HyveSynth/HyveSynth/README.md

# Hyve Synth

## By Skot Wiedmann
**Hyve Touch Synth is a fun, expressive musical instrument you can make, hack and play. Build or play a beautiful analog synth that responds to touch and movement!**

### Documentation

In this repository you will find the schematic and playing surface layouts, as well as some useful guides for tuning and DIY building and hacking.

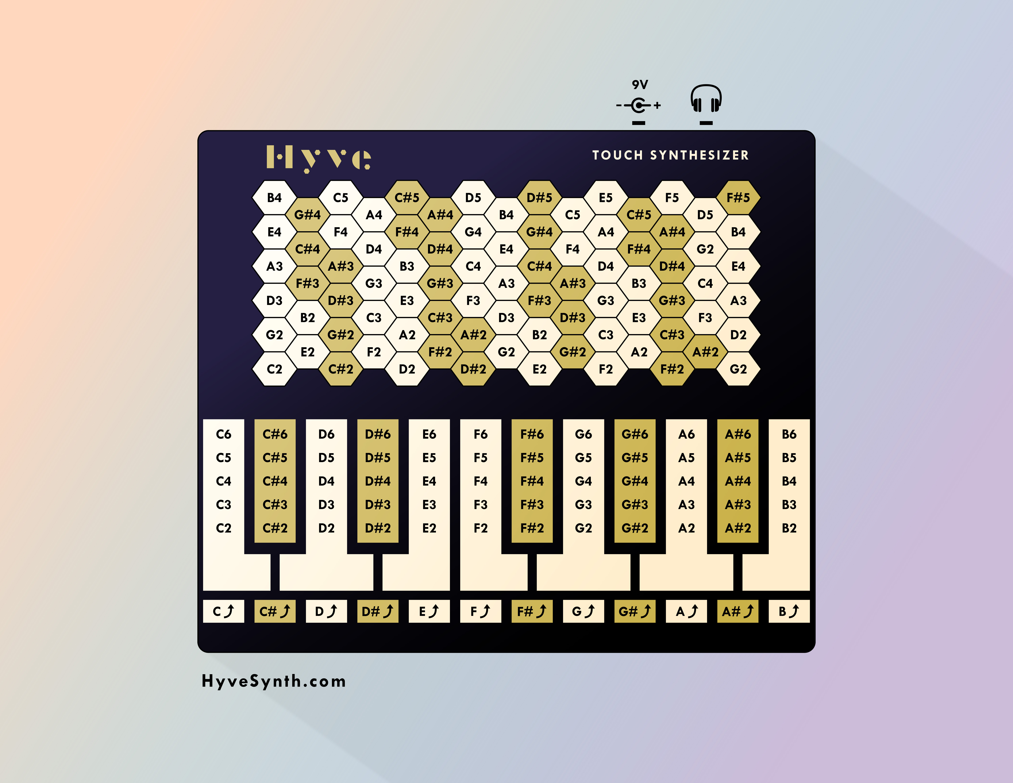
[picture p1: HyveDiagram.jpg]
HyveDiagram
