HyveSynth/HyveSynth/CuttingTemplate1.png

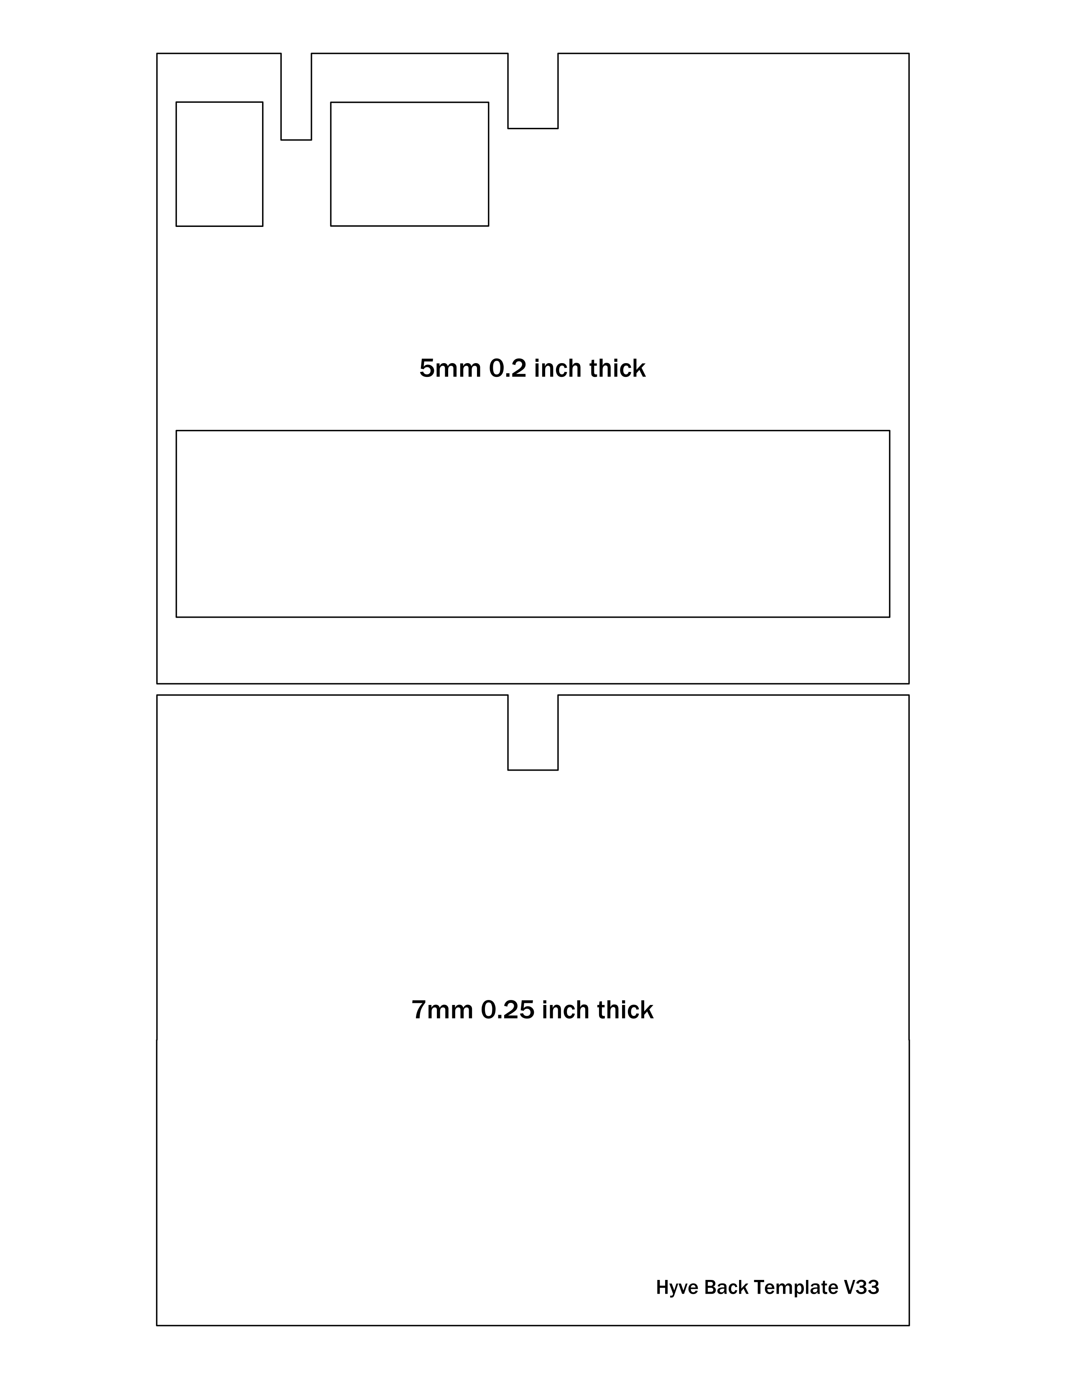
CuttingTemplate1.png
