HyveSynth/HyveSynth/Hyve43Schematic.png

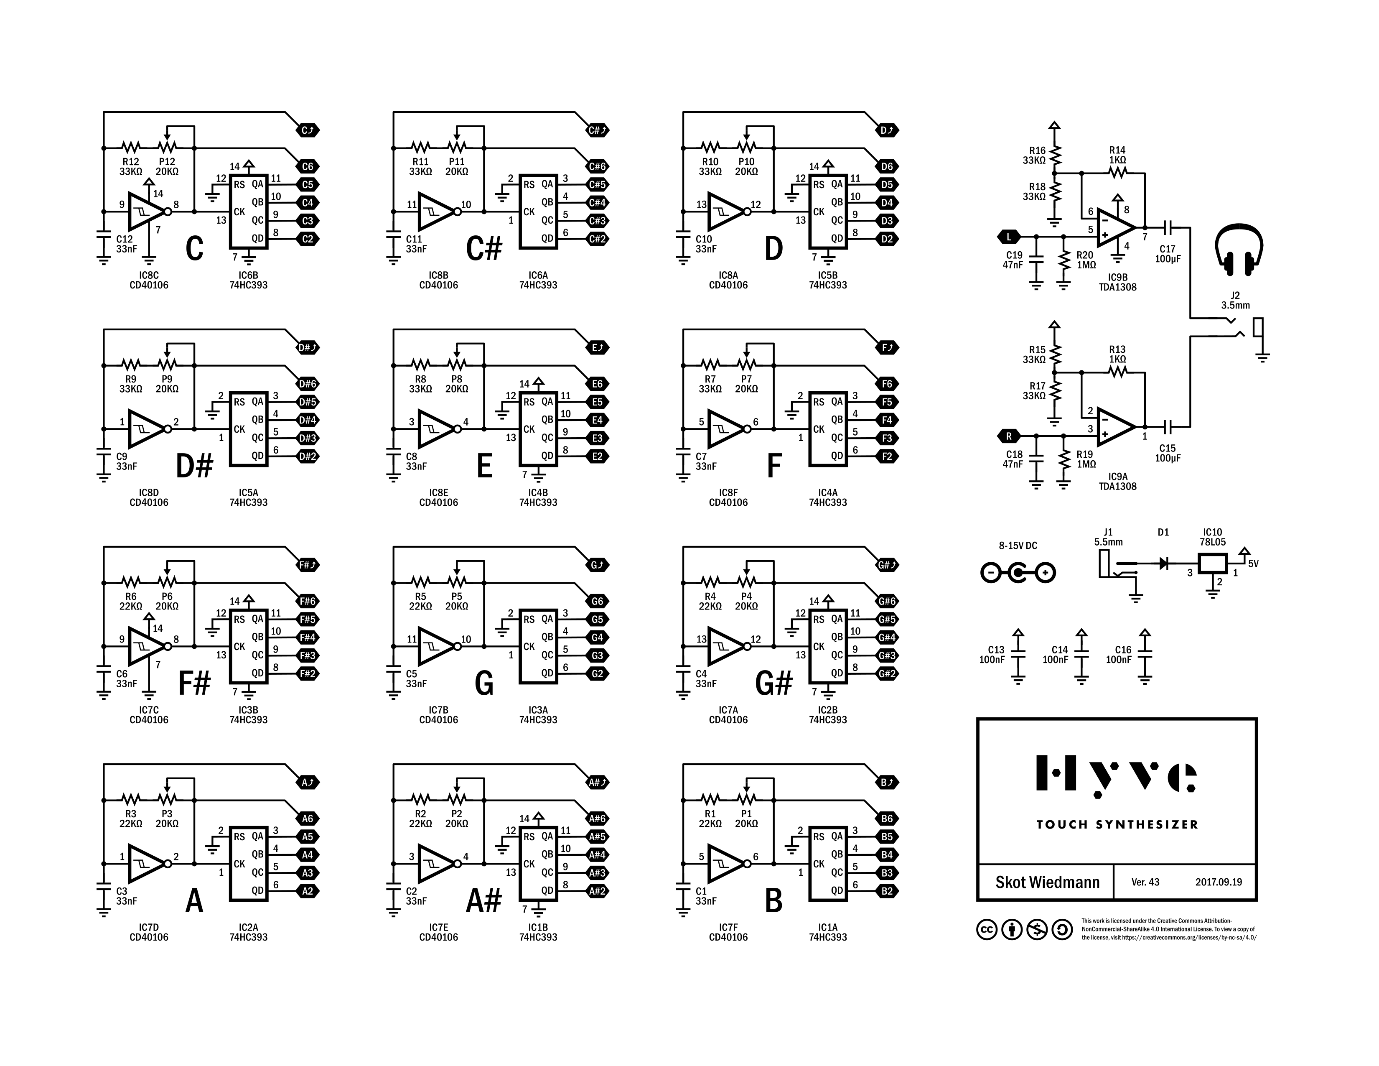
Hyve43Schematic.png
