HyveSynth/HyveSynth/HyveSurfaceLayout.png

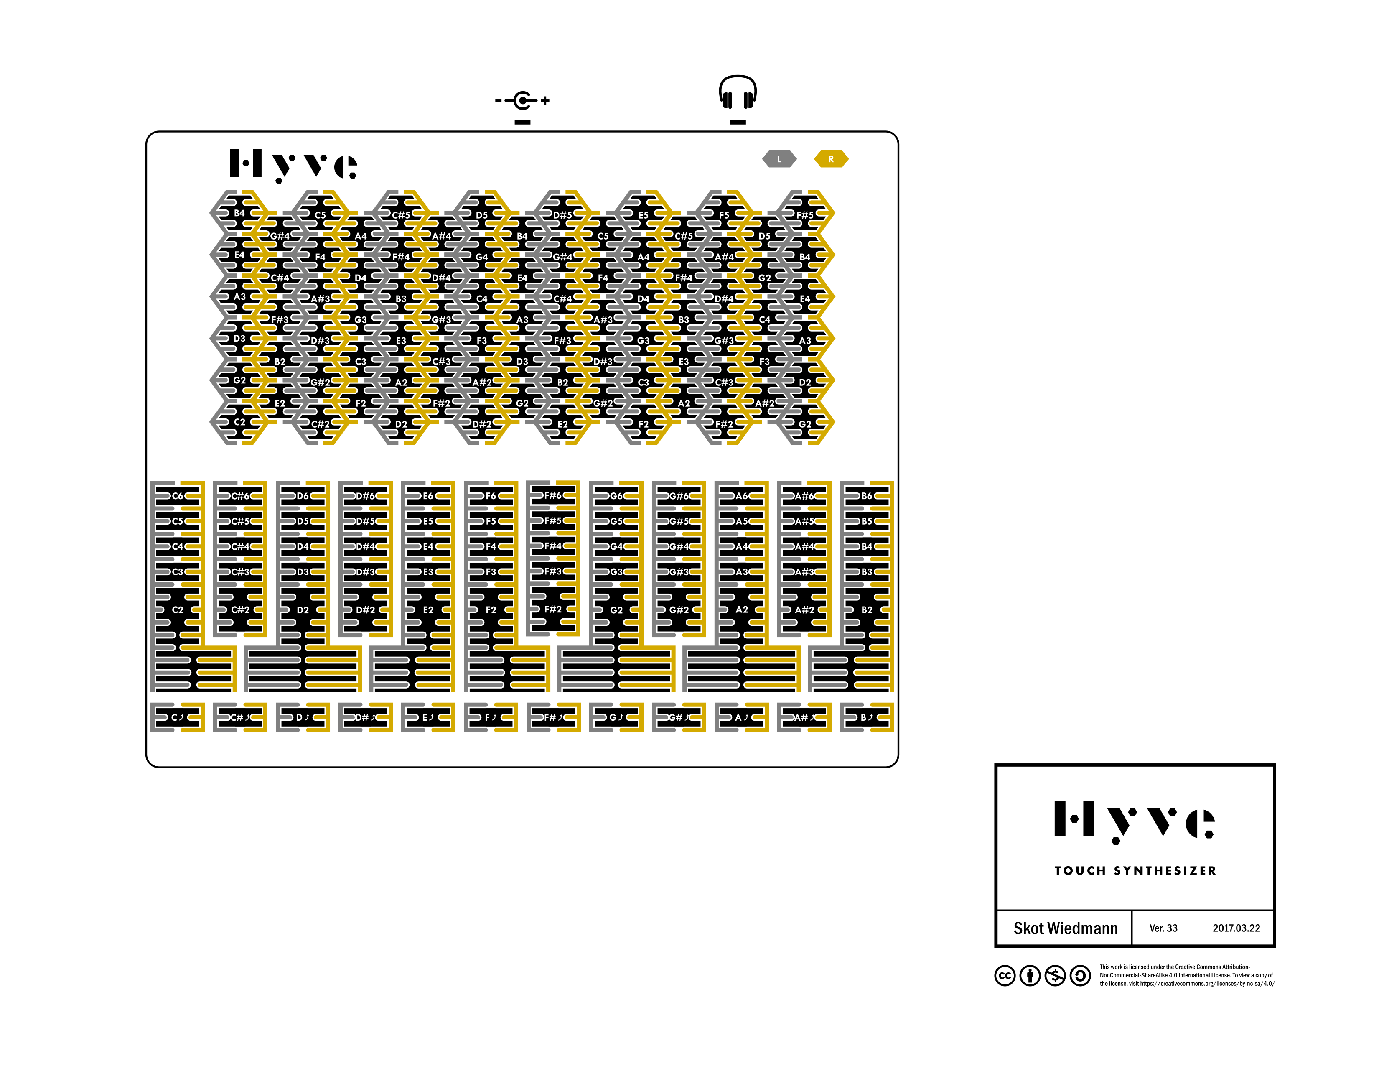
HyveSurfaceLayout.png
