HyveSynth/HyveSynth/Hyve BOM V45.xlsx

Hyve BOM V45 | updated 2019.27.11
Direct Link: | https://www.mouser.com/ProjectManager/ProjectDetail.aspx?AccessID=55c2f2d16f
Digi-Key Part Number | Manufacturer | Manufacturer Part Number | Designator | Quantity | Description | Notes
296-14851-1-ND | TEXAS INSTRUMENTS | SN74HC393DR | IC1 IC2 IC3 IC4 IC5 IC6 | 6 | IC DUAL 4BIT BINRY COUNTR 14SOIC
296-14081-1-ND | TEXAS INSTRUMENTS | CD40106BM96 | IC7 IC8 | 2 | IC INVERTER GATE HEX 14SOIC | Do not substitute
568-11063-1-ND | NXP USA INC | TDA1308T/N2,115 | IC9 | 1 | IC AMP AUDIO 3W STER AB 8SOIC | Substitute: TPA112 or LM4808; SOIC only
296-13531-1-ND | TEXAS INSTRUMENTS | UA78L05CPK | IC10 | 1 | IC REG LDO 5V 0.1A SOT89-3
399-1249-1-ND | KEMET | C1206C104K5RAC7867 | C13 C14 C16 | 3 | CAP CER 0.1UF 50V X7R 1206 | Substitute with any 0.1UF 1206 >6V
36-4003-ND | KEYSTONE ELECTRONICS | 4003 | TUNING TOOL | 1 | CONN TERM LUG RING TH | Optional
TC33X-2-203ECT-ND | BOURNS INC | TC33X-2-203E | P1 P2 P3 P4 P5 P6 P7 P8 P9 P10 P11 P12 | 12 | TRIMMER 20K OHM 0.1W SMD
311-1.0KERCT-ND | YAGEO | RC1206JR-071KL | R13 R14 | 2 | RES SMD 1K OHM 5% 1/4W 1206
311-22KERCT-ND | YAGEO | RC1206JR-0722KL | R1 R2 R3 R4 R5 R6 | 6 | RES SMD 22K OHM 5% 1/4W 1206
311-33KERCT-ND | YAGEO | RC1206JR-0733KL | R7 R8 R9 R10 R15 R16 R17 R18 | 8 | RES SMD 33K OHM 5% 1/4W 1206
311-39KERCT-ND | YAGEO | RC1206JR-0739KL | R11 R12 | 2 | RES SMD 39K OHM 5% 1/4W 1206
311-1.0MERCT-ND | YAGEO | RC1206JR-071ML | R19 R20 | 2 | RES SMD 1M OHM 5% 1/4W 1206
445-6981-1-ND | TDK | CGA5F2C0G1H333J085AA (https://www.mouser.com/ProductDetail/810-CGA5F2C0G1H333J) | C1 C2 C3 C4 C5 C6 C7 C8 C9 C10 C11 C12 | 12 | CAP CER 0.033UF 50V C0G 1206
399-9364-1-ND | KEMET | C1206C473M5RACTU | C18 C19 | 2 | CAP CER 0.047UF 50V X7R 1206
490-4539-1-ND | MURATA ELECTRONICS | GRM31CR60J107ME39L | C15 C17 | 2 | CAP CER 100UF 6.3V X5R 1206 | Substitute with any 100UF 1206 >6V
CP-002AHPJCT-ND | CUI INC | PJ-002AH-SMT-TR | J1 | 1 | CONN PWR JACK 2X5.5MM SOLDER
CP-3523SJCT-ND | CUI INC | SJ-3523-SMT-TR | J2 | 1 | CONN JACK STEREO 3.5MM SMD R/A
MBRS1100T3GOSCT-ND | ON SEMICONDUCTOR | MBRS1100T3G | D1 | 1 | Diode Schottky 100V 1A Surface Mount SMB | Most any diode would work in this location
